tasnim04/Robotic-Prosthetic-Arm-/Electrical wiring.png

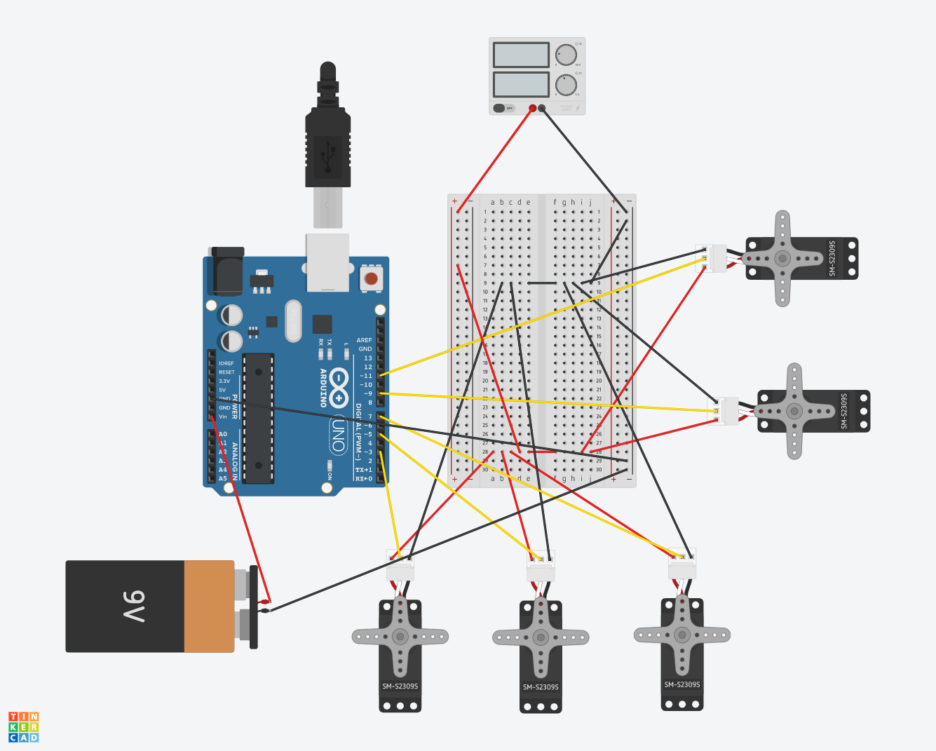
Electrical wiring.png
